Sreeram-R-6/smart-medicine-box/firmware/stm32/oled_test.h

#pragma once
// SSD1306-compatible 128x64 trial driver. No controller autodetection claimed.
static uint8_t oled_address, oled_ready, oled_page, oled_chunk;
static uint32_t oled_errors, oled_frames;
static uint32_t oled_attempts, oled_last_attempt, oled_last_health;
static uint32_t oled_last_transfer;
static uint8_t oled_started,oled_lit;
static uint8_t oled_positioned,oled_frame_failures;
static uint8_t oled_contrast=127,oled_dirty_pages,oled_force_redraw=1;
static uint8_t oled_pixels[1024];
static uint8_t oled_sent[1024];
static int oled_write(uint8_t *p,unsigned n){
 oled_last_transfer=HAL_GetTick();
 if(bus_write(oled_address,p,n)==HAL_OK)return 1;
 oled_errors++;oled_ready=0;oled_last_attempt=HAL_GetTick();
 logmsg("OLED/WARN","I2C error=%lu byte=%lu cmd=0x%02X len=%u; retry in 2s",(unsigned long)i2c_error,(unsigned long)soft_i2c_write_failed_byte,n>1?p[1]:0,n);i2c_recover();return 0;
}
static void oled_init(void){
 oled_started=1;oled_attempts++;oled_last_attempt=HAL_GetTick();
 oled_ready=0;oled_lit=0;oled_address=0;
 for(uint8_t a=0x3c;a<=0x3d;a++)if(bus_probe(a)==HAL_OK){oled_address=a;break;}
 if(!oled_address){logmsg("OLED/WARN","No ACK at 0x3C/0x3D; retry in 2s");i2c_recover();return;}
 uint8_t init[]={0,0xae,0xd5,0x80,0xa8,OLED_HEIGHT-1,0xd3,0,0x40,
  0x8d,0x14,0x20,2,0xa1,0xc8,0xda,0x12,0x81,oled_contrast,0xd9,0xf1,0xdb,0x40,0xa4,0xa6};
 oled_ready=1;
 // Keep command/argument pairs together, with a STOP between commands.
 // This also lets a freshly powered module settle without one long burst.
 for(unsigned i=1;i<sizeof init&&oled_ready;){
  uint8_t cmd[3]={0,init[i++]};unsigned n=2;
  if(cmd[1]==0xd5||cmd[1]==0xa8||cmd[1]==0xd3||cmd[1]==0x8d||cmd[1]==0x20||cmd[1]==0xda||cmd[1]==0x81||cmd[1]==0xd9||cmd[1]==0xdb)cmd[n++]=init[i++];
  oled_ready=(uint8_t)oled_write(cmd,n);HAL_Delay(1);
 }
 oled_page=OLED_HEIGHT/8;oled_chunk=0;oled_positioned=0;oled_frame_failures=0;
 if(oled_ready){display_dirty=1;oled_force_redraw=1;oled_last_health=HAL_GetTick();}
 logmsg("OLED/INFO","Address=0x%02X SSD1306 128x64 trial ready=%u; verify screen visually",oled_address,oled_ready);
}
static void oled_next_page(void){
 for(oled_page=0;oled_page<OLED_HEIGHT/8;oled_page++)if(oled_dirty_pages&(1u<<oled_page))break;
 oled_chunk=0;oled_positioned=0;
}
static void oled_begin_frame(void){
 oled_dirty_pages=0;
 for(unsigned p=0;p<OLED_HEIGHT/8;p++)if(oled_force_redraw||memcmp(oled_pixels+p*128,oled_sent+p*128,128)!=0)oled_dirty_pages|=(uint8_t)(1u<<p);
 oled_force_redraw=0;oled_next_page();
}
static void oled_poll(void){
 if(!oled_ready){
  if(oled_started && (uint32_t)(HAL_GetTick()-oled_last_attempt)>=2000)oled_init();
  return;
 }
 if((uint32_t)(HAL_GetTick()-oled_last_transfer)<2)return;
 if(oled_page>=OLED_HEIGHT/8){
  if(!oled_lit)return; // Never expose uninitialized RAM before a complete frame.
  if((uint32_t)(HAL_GetTick()-oled_last_health)>=2000){
   oled_last_health=HAL_GetTick();uint8_t on[]={0,0xaf};oled_write(on,sizeof on);
  }
  return;
 }
 // Re-address every chunk. A slave may have accepted only part of a failed
 // write; retrying data without restoring its column would shift the picture.
 unsigned column=oled_chunk*16;
 uint8_t packet[17]={0x40};unsigned length;
 if(!oled_positioned){packet[0]=0;packet[1]=(uint8_t)(0xb0+oled_page);packet[2]=(uint8_t)(column&15);packet[3]=(uint8_t)(0x10|(column>>4));length=4;}
 else{memcpy(packet+1,oled_pixels+oled_page*128+column,16);length=17;}
 oled_last_transfer=HAL_GetTick();
 if(bus_write(oled_address,packet,length)!=HAL_OK){
  oled_errors++;oled_positioned=0;i2c_recover();
  if(++oled_frame_failures>=3){oled_ready=0;oled_last_attempt=HAL_GetTick();}
  return;
 }
 if(!oled_positioned){oled_positioned=1;return;}
 oled_positioned=0;oled_frame_failures=0;
 memcpy(oled_sent+oled_page*128+column,packet+1,16);
 if(++oled_chunk==8){
  oled_dirty_pages&=(uint8_t)~(1u<<oled_page);oled_next_page();
  if(oled_page==OLED_HEIGHT/8){
   if(!oled_lit){uint8_t on[]={0,0xaf};if(!oled_write(on,sizeof on))return;oled_lit=1;}
   oled_frames++;
  }
 }
}
