Sreeram-R-6/smart-medicine-box/(commit log)

2026-10-30 Harden shared I2C recovery and document unresolved OLED bench failures
    [config.h, main.c, menu.c, oled_driver_test.c, oled_test.h, soft_i2c.c, soft_i2c.h, soft_i2c_test.c]
2026-10-30 Reverse lid polarity to chirp on opening after rewiring
    [config.h]
2026-10-30 Keep OLED off until first complete frame and expose failed-byte diagnostics
    [config.h, menu.c, oled_driver_test.c, oled_test.h, soft_i2c.c, soft_i2c.h, soft_i2c_test.c]
2026-10-30 Use measured closed-low open-high lid calibration
2026-10-30 Record verified opening chirp and electrically held-low I2C bus
